javist94/powerhacker/hardware/powerhacker-BOM-costs.xls

ID | Name | Designator | Footprint | Quantity per board | Manufacturer Part | Manufacturer | Supplier | Supplier Part | Part Price | Min. Order | Order qty | Order cost | Manuf. Boards
1 | 220 | R19,R36,R37,R20 | R0805 | 4 | 0805W8F2200T5E | UniOhm | LCSC | C17557 | 0.0017210 € | 100 | 100 | 0.1721 € | 25.0
2 | MICRO5.9MMUSB | USB2 | MICRO-USB-SMD_5P-P0.65-H-F_MICRO5.9MMUSB | 1 | MICRO5.9mmusb | SHOU HAN | LCSC | C393940 | 0.0229090 € | 20 | 20 | 0.4582 € | 20.0 | BOARDS | 2
3 | 10nF | C16,C12,C9,C19 | C0603 | 4 | CGA3E2X7R1H103KT0Y0N | TDK | LCSC | C342901 | 0.0079530 € | 50 | 50 | 0.3977 € | 12.5
4 | 100K | R13 | R0603 | 1 | 0603WAF1003T5E | UniOhm | LCSC | C25803 | 0.0008140 € | 100 | 100 | 0.0814 € | 100.0 | ORDER PRICE | 39.06 €
5 | LTST-C190KGKT | CH2,CH1 | LED0603-RD | 2 | LTST-C190KGKT | LITEON | LCSC | C125094 | 0.0154220 € | 20 | 20 | 0.3084 € | 10.0
6 | 100 | R23 | R0805 | 1 | 0805W8F1000T5E | UniOhm | LCSC | C17408 | 0.0017610 € | 100 | 100 | 0.1761 € | 100.0 | BOARD COST | 19.53 €
7 | 1.62K | R5 | R0603 | 1 | WR06X1621FTL | WTC | LCSC | C170482 | 0.0026650 € | 100 | 100 | 0.2665 € | 100.0
8 | 100nF | C23,C27,C6,C28,C26 | C0603 | 5 | 0603B104K160 | WTC | LCSC | C80516 | 0.0030300 € | 50 | 50 | 0.1515 € | 10.0
9 | 2STBN15D100 | Q4,Q1 | TO-263-2_L10.0-W9.1-P5.08-LS15.2-TL | 2 | 2STBN15D100 | STMicroelectronics | LCSC | C155667 | 0.7183760 € | 2 | 4 | 2.8735 € | 2.0
10 | MAX9934FAUA+ | U4 | MSOP-8_L3.0-W3.0-P0.65-LS5.0-BL | 1 | MAX9934FAUA+ | MAXIM | MOUSER ES | C143634 | 1.9500000 € | 1 | 2 | 3.9000 € | 2.0
11 | AP7381-33Y-13 | U2 | SOT-89-3_L4.5-W2.5-P1.50-LS4.2-BR | 1 | AP7381-33Y-13 | Diodes Incorporated | LCSC | C460411 | 0.1050470 € | 5 | 5 | 0.5252 € | 5.0 | MINIMUM COST | 26.16 €
12 | TPS560430XFDBVR | U9 | SOT-23-6_L2.9-W1.6-P0.95-LS2.8-BR | 1 | TPS560430XFDBVR | Texas Instruments | MOUSER ES | C523980 | 1.0100000 € | 1 | 2 | 2.0200 € | 2.0
13 | 15uH | L1 | IND-SMD_L4.0-W4.0 | 1 | SNR4018K-150M | 3L COILS | LCSC | C326304 | 0.0851220 € | 5 | 5 | 0.4256 € | 5.0
14 | 470 | R3 | R0603 | 1 | WR06X471JTL | WALSIN | LCSC | C163921 | 0.0008170 € | 100 | 100 | 0.0817 € | 100.0
15 | 2.2uF | C32,C25,C38 | C1210 | 3 | C3225X7R2A225KT5L0U | TDK | LCSC | C76686 | 0.2048110 € | 3 | 6 | 1.2289 € | 2.0
16 | 100nF | C39,C40,C34,C5 | C0603 | 4 | CC0603JRX7R9BB104 | YAGEO | LCSC | C91183 | 0.0104070 € | 50 | 50 | 0.5203 € | 12.5
17 | 412K | R31 | R0603 | 1 | ERJ3EKF4123V | PANASONIC | LCSC | C403212 | 0.0066460 € | 50 | 50 | 0.3323 € | 50.0
18 | SS14L | D1 | SMA_L4.4-W2.6-LS5.0-RD | 1 | SS14L | PANJIT | LCSC | C125883 | 0.0392250 € | 10 | 10 | 0.3923 € | 10.0
19 | 32.768KHz | X1 | SMD-3215_2P | 1 | DST310S 32.768KHz | KDS Daishinku | LCSC | C93232 | 0.3423260 € | 1 | 2 | 0.6847 € | 2.0
20 | 10uF | C20 | CAP-SMD_BD4.0-L4.3-W4.3-FD | 1 | EEEFC1C100AR | PANASONIC | LCSC | C401619 | 0.1052510 € | 5 | 5 | 0.5263 € | 5.0
21 | 150nH | L2 | L0603 | 1 | 0603AF-151XJEU | Coilcraft | LCSC | C335693 | 0.3562440 € | 1 | 2 | 0.7125 € | 2.0
22 | STM32F373CCT6 | U5 | LQFP-48_L7.0-W7.0-P0.50-LS9.0-TL | 1 | STM32F373CCT6 | STMicroelectronics | LCSC | C89403 | 2.4642680 € | 1 | 2 | 4.9285 € | 2.0
23 | 19-217/R6C-AL1M2VY/3T | USB,POWER,SD | LED0603-R-RD | 3 | 19-217/R6C-AL1M2VY/3T | EVERLIGHT | LCSC | C72044 | 0.0125040 € | 20 | 20 | 0.2501 € | 6.7
24 | 0.04 | R7 | R0805 | 1 | STE0805MW75R040F | Walter Elec | LCSC | C201265 | 0.0515660 € | 10 | 10 | 0.5157 € | 10.0
25 | 280 | R24,R21 | R0805 | 2 | 0805W8F2800T5E | Uniroyal Elec | LCSC | C247037 | 0.0024400 € | 100 | 100 | 0.2440 € | 50.0
26 | TS-1087S-01626 | SW1,SW2,SW3,SW4 | SW-SMD_L5.2-W5.2-P3.70-LS6.4 | 4 | TS-1087S-01626 | XUNPU | LCSC | C455263 | 0.0294710 € | 20 | 20 | 0.5894 € | 5.0
27 | 1.5K | R14 | R0603 | 1 | TC0325B1501T5E | UNI-ROYAL | LCSC | C39049 | 0.0307830 € | 10 | 10 | 0.3078 € | 10.0
28 | 1M | R11 | R0603 | 1 | 0603WAF1004T5E | UniOhm | LCSC | C22935 | 0.0009860 € | 100 | 100 | 0.0986 € | 100.0
29 | NSI50010YT1G | U12 | SOD-123_L2.8-W1.8-LS3.7-RD | 1 | NSI50010YT1G | ON Semicon | LCSC | C150049 | 0.1020600 € | 5 | 5 | 0.5103 € | 5.0
30 | 100K | R35 | 805 | 1 | 080500F1003T5E | UniOhm | LCSC | C149504 | 0.0021620 € | 100 | 100 | 0.2162 € | 100.0
31 | 470uF | C1 | CAP-SMD_BD10.0-L10.3-W10.3-FD | 1 | RVT1V471M1010 | ROQANG | LCSC | C72519 | 0.0987890 € | 5 | 5 | 0.4939 € | 5.0
32 | 13.7K | R38 | R0603 | 1 | 0603WAD1372T5E | Uniroyal Elec | LCSC | C407628 | 0.0032880 € | 50 | 50 | 0.1644 € | 50.0
33 | 470uF | C3 | CAP-SMD_BD6.3-L6.6-W6.6-FD | 1 | RVT1A471M0607 | ROQANG | LCSC | C335982 | 0.0340650 € | 10 | 10 | 0.3407 € | 10.0
34 | 1uF | C4 | C0603 | 1 | CL10A105KB8NNNC | SAMSUNG | LCSC | C15849 | 0.0075860 € | 50 | 50 | 0.3793 € | 50.0
35 | 10.2K | R2 | R0603 | 1 | 0603WAF1022T5E | UniOhm | LCSC | C22772 | 0.0009050 € | 100 | 100 | 0.0905 € | 100.0
36 | 19-217/BHC-ZL1M2RY/3T | RUN | LED0603-R-RD | 1 | 19-217/BHC-ZL1M2RY/3T | EVERLIGHT | LCSC | C72041 | 0.0137970 € | 20 | 20 | 0.2759 € | 20.0
37 | 100nF | C7 | C1206 | 1 | CGA5L2C0G1H104JT0Y0N | TDK | LCSC | C338082 | 0.4475140 € | 1 | 2 | 0.8950 € | 2.0
38 | 0.1 | R32 | R0603 | 1 | 0603WAJ010KT5E | Uniroyal Elec | LCSC | C247025 | 0.0025000 € | 100 | 100 | 0.2500 € | 100.0
39 | 22 | R34,R33 | R0805 | 2 | 0805W8J0220T5E | UniOhm | LCSC | C25295 | 0.0016810 € | 100 | 100 | 0.1681 € | 50.0
40 | NSR05F20NXT5G | D3 | DSN2_L1.6-W0.8-RD | 1 | NSR05F20NXT5G | ON | LCSC | C94366 | 0.1859560 € | 1 | 2 | 0.3719 € | 2.0
41 | 4.7uF | C35,C36,C2 | CAP-SMD_BD4.0-L4.3-W4.3-FD | 3 | EEEFK1V4R7R | PANASONIC | LCSC | C401730 | 0.1065490 € | 3 | 6 | 0.6393 € | 2.0
42 | 10uF | C37 | C1206 | 1 | CL31B106KBHNNNE | SAMSUNG | LCSC | C89632 | 0.0668770 € | 5 | 5 | 0.3344 € | 5.0
43 | 1N4001W | D7,D4,D5 | SOD-123F_L2.8-W1.8-LS3.7-RD | 3 | 1N4001W | Jingdao | LCSC | C162732 | 0.0054160 € | 50 | 50 | 0.2708 € | 16.7
44 | 100nF | C8,C24 | C0805 | 2 | C2012X7R2A104KT0L0U | TDK | LCSC | C76652 | 0.0215660 € | 20 | 20 | 0.4313 € | 10.0
45 | 5.6pF | C22,C21 | C0603 | 2 | 0603CG5R6C500NT | FH | LCSC | C1674 | 0.0033140 € | 50 | 50 | 0.1657 € | 25.0
46 | 3.3K | R6 | R0805 | 1 | RN732ATTD3301B25 | KOA Speer Elec | LCSC | C186487 | 0.1726020 € | 1 | 2 | 0.3452 € | 2.0
47 | 0.1 | R4 | R0805 | 1 | RTT05R100FTP | RALEC | LCSC | C125639 | 0.0042500 € | 50 | 50 | 0.2125 € | 50.0
48 | 8MHz | X3 | OSC-SMD_4P-L5.0-W3.2-BL | 1 | S5308000201080 | JGHC | LCSC | C390780 | 0.2054440 € | 1 | 2 | 0.4109 € | 2.0
49 | DC-005-5A-2.0 | DC1 | DC-IN-TH_DC-005-5A-2.0 | 1 | DC-005-5A-2.0 | XKB Enterprise | LCSC | C381116 | 0.1618260 € | 1 | 2 | 0.3237 € | 2.0
50 | MAX4172ESA+T | U8 | SOIC-8_L5.0-W4.0-P1.27-LS6.0-BL | 1 | MAX4172ESA+T | Maxim Integrated | MOUSER ES | C113251 | 2.9800000 € | 1 | 2 | 5.9600 € | 2.0
51 | 620 | R22 | R0805 | 1 | RC0805FR-07620RL | YAGEO | LCSC | C137503 | 0.0022600 € | 100 | 100 | 0.2260 € | 100.0
52 | 1uF | C10,C17,C11 | C0603 | 3 | C1608X7R1E105KT000N | TDK | LCSC | C76619 | 0.0185420 € | 20 | 20 | 0.3708 € | 6.7
53 | 220Ω | L3 | L0603 | 1 | BLM18PG221SN1D | MuRata | LCSC | C80165 | 0.0076620 € | 50 | 50 | 0.3831 € | 50.0
54 | 200K | R30 | R0402 | 1 | AECR0402F200KK9 | ResistorToday | LCSC | C328308 | 0.0015310 € | 100 | 100 | 0.1531 € | 100.0
55 | 22uF | C33 | C0805 | 1 | CL21A226MQCLRNC | Samsung Electro-Mechanics | LCSC | C307530 | 0.0286340 € | 10 | 10 | 0.2863 € | 10.0
56 | 100nF | C29,C30,C31 | C0603 | 3 | 0603F104M500NT | FH | LCSC | C42998 | 0.0028960 € | 50 | 50 | 0.1448 € | 16.7
57 | 2K | R39 | R0603 | 1 | WR06X202 JTL | Walsin Tech Corp | LCSC | C384268 | 0.0008000 € | 100 | 100 | 0.0800 € | 100.0
58 | TF-115 | CARD1 | TF-SMD_TF-115 | 1 | TF-115 | XUNPU | LCSC | C266620 | 0.1229630 € | 1 | 2 | 0.2459 € | 2.0
59 | LM358ST | U10 | MSOP-8_L3.0-W3.0-P0.65-LS5.0-BL | 1 | LM358ST | STMicroelectronics | LCSC | C54867 | 0.1293370 € | 1 | 2 | 0.2587 € | 2.0
60 | 4.7uF | C18 | C0805 | 1 | C2012X7R1E475KT000N | TDK | LCSC | C76642 | 0.0819360 € | 5 | 5 | 0.4097 € | 5.0
61 | 10K | R18,R9,R15,R17,R12,R1,R16,R8 | R0603 | 8 | RS-03K1002FT | Guangdong Fenghua Advanced Tech | LCSC | C115324 | 0.0008330 € | 100 | 100 | 0.0833 € | 12.5
