javist94/powerhacker/hardware/schematics/input-stage.pdf

## SMARTBOARD INPUT POWER MANAGEMENT SCHEMATIC

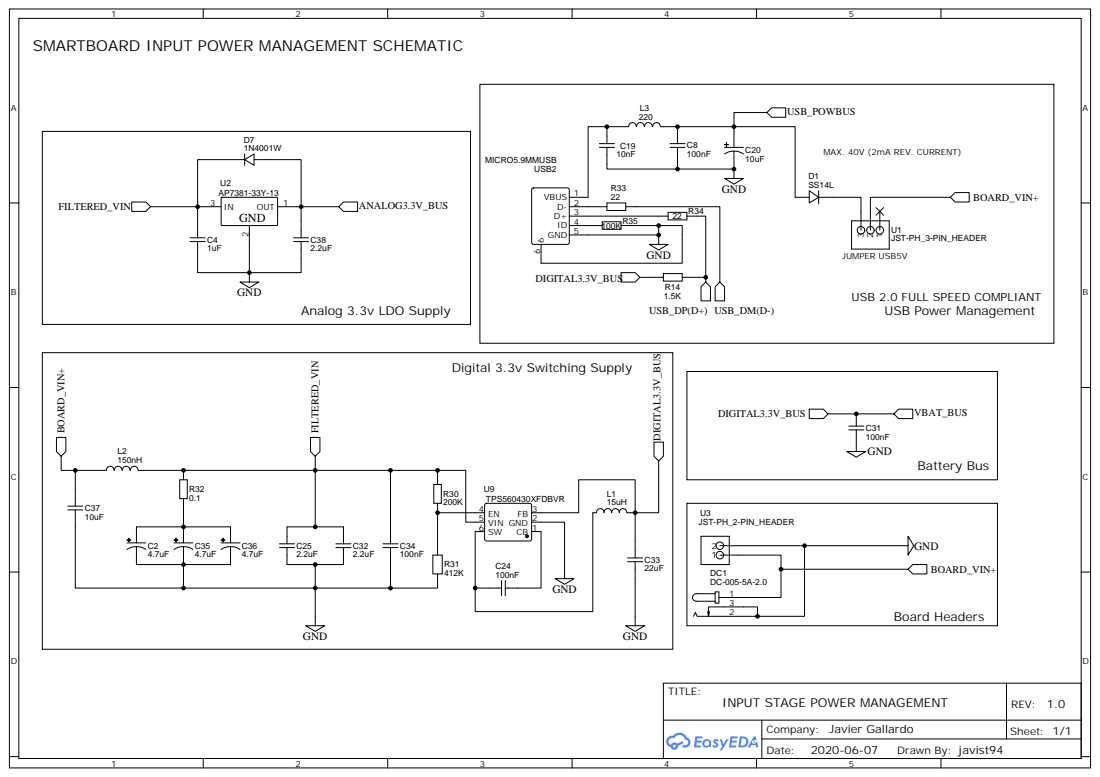
[picture p2: page 1]

USB 2.0 FULL SPEED COMPLIANT
USB Power Management
