javist94/powerhacker/hardware/pcb-routing/pcb-100x60mm-prototype.pdf

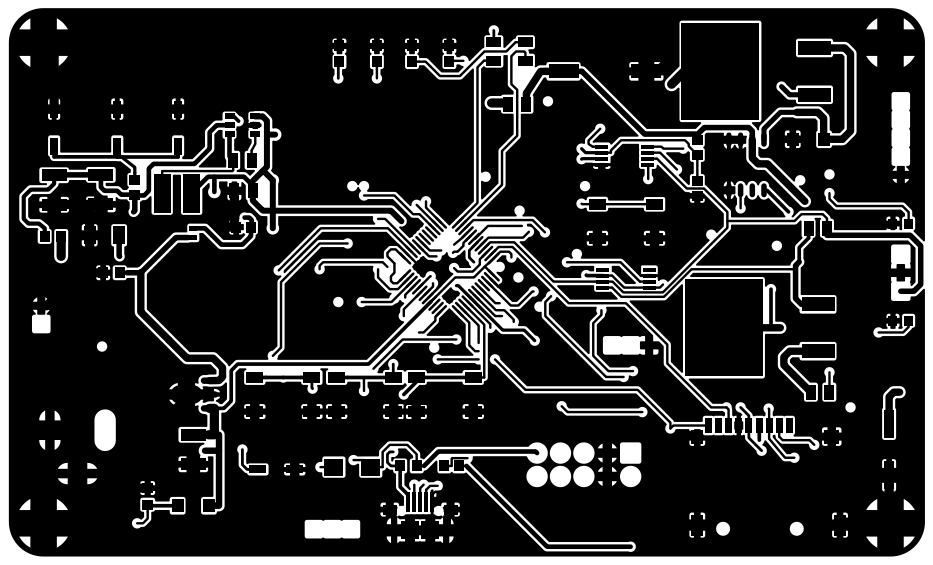
[picture p3: page 1]

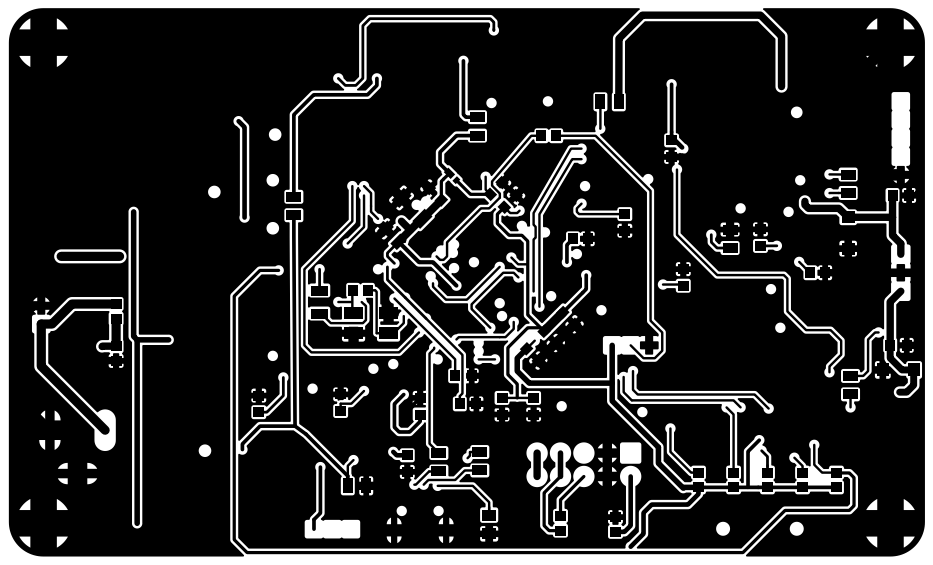
[picture p4: page 2]

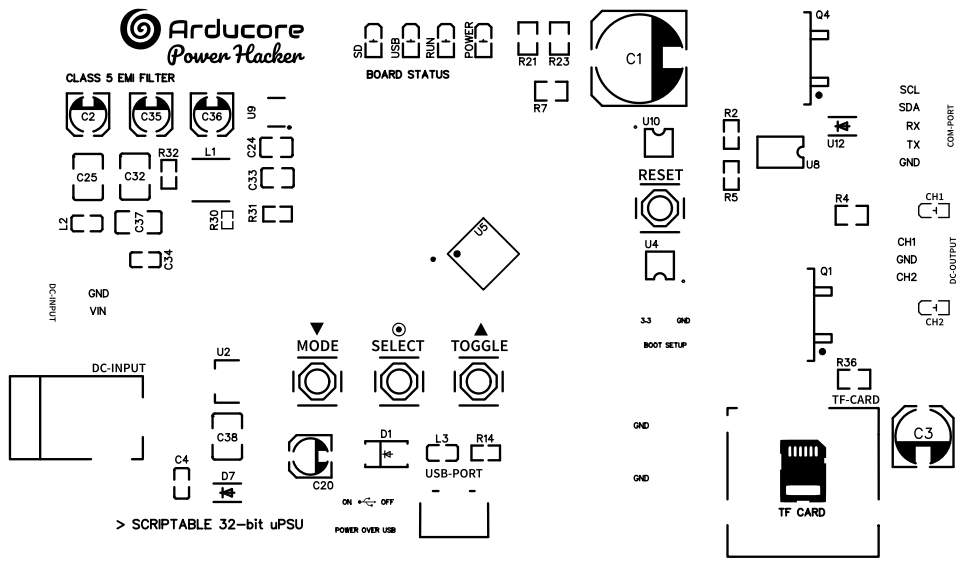
[picture p5: page 3]

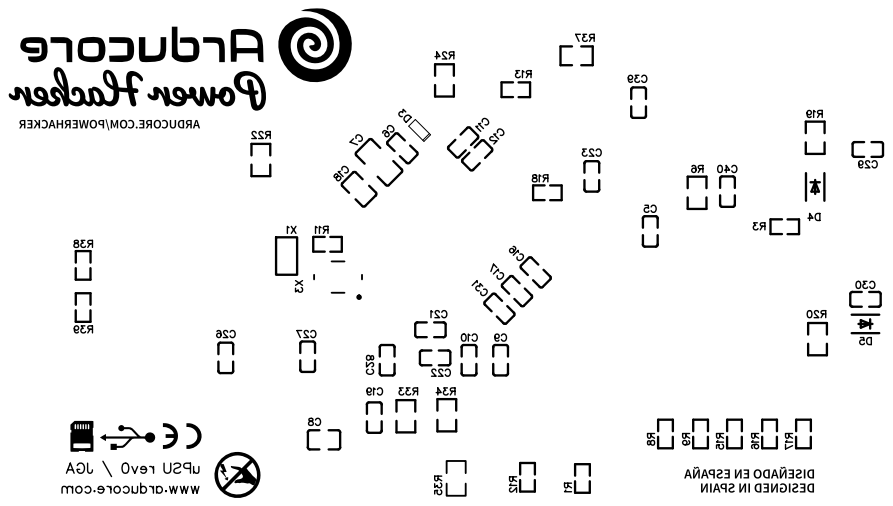
[picture p6: page 4]

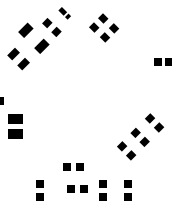
[picture p7: figure]

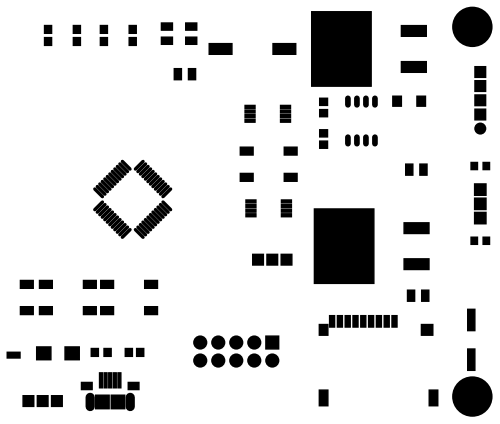
[picture p8: figure]

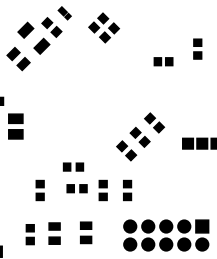
[picture p9: figure]

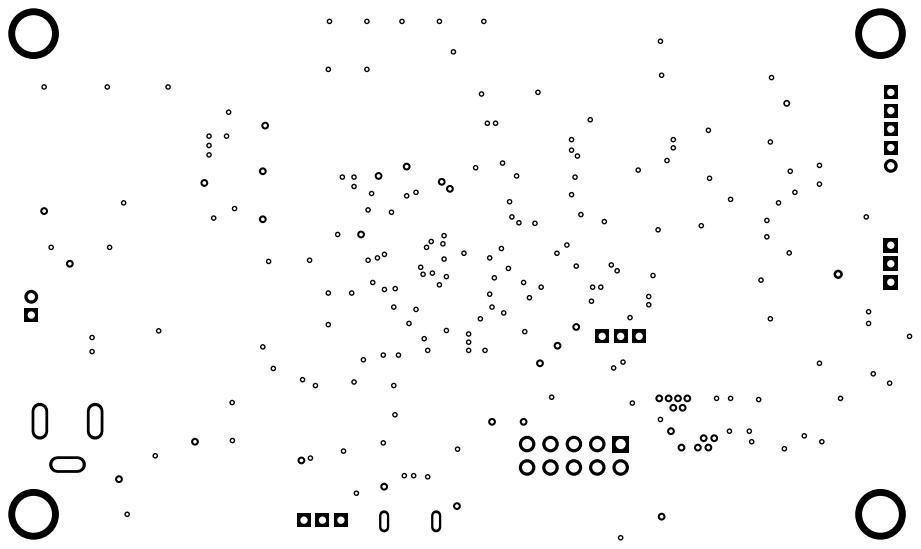
[picture p10: page 10]

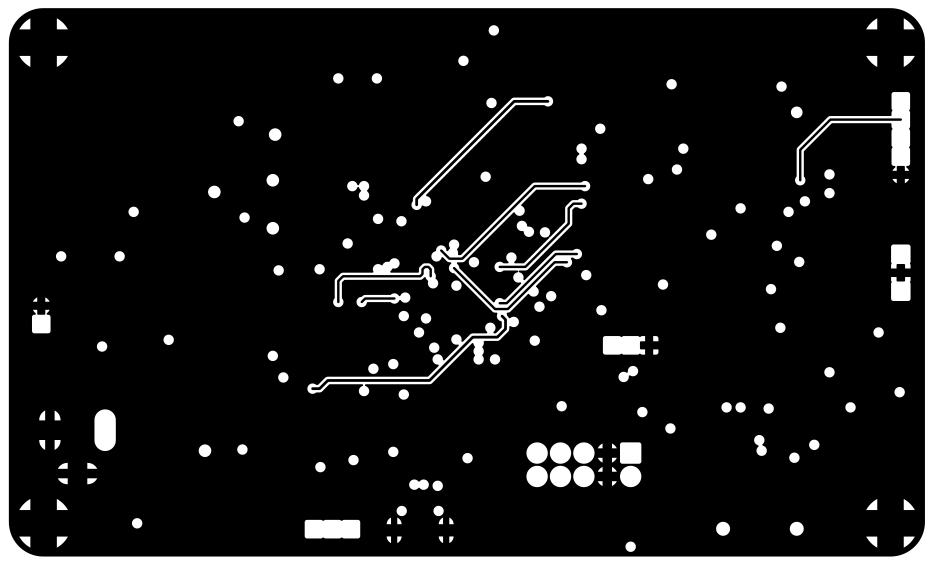
[picture p11: page 12]

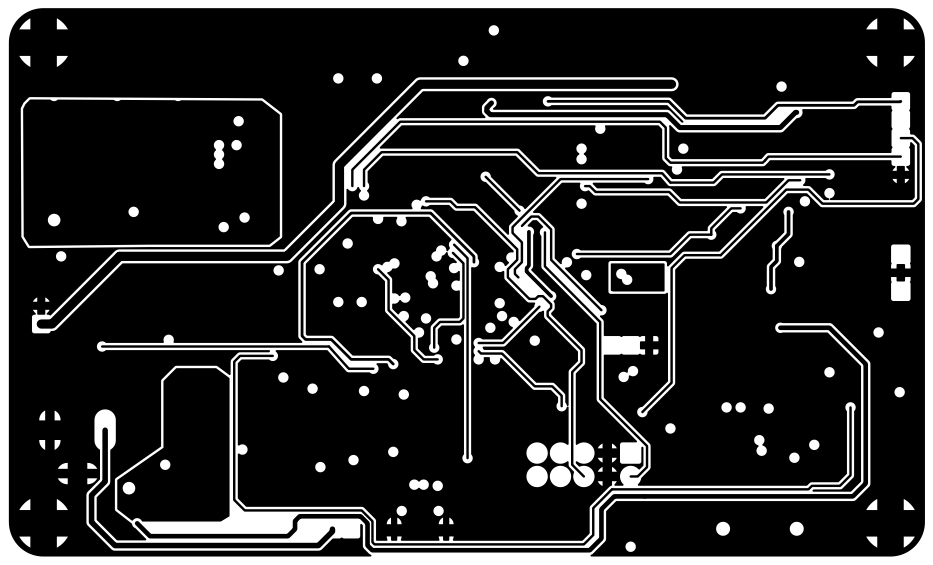
[picture p12: page 13]
