javist94/powerhacker/hardware/schematics/leds-ports-sdcard.pdf

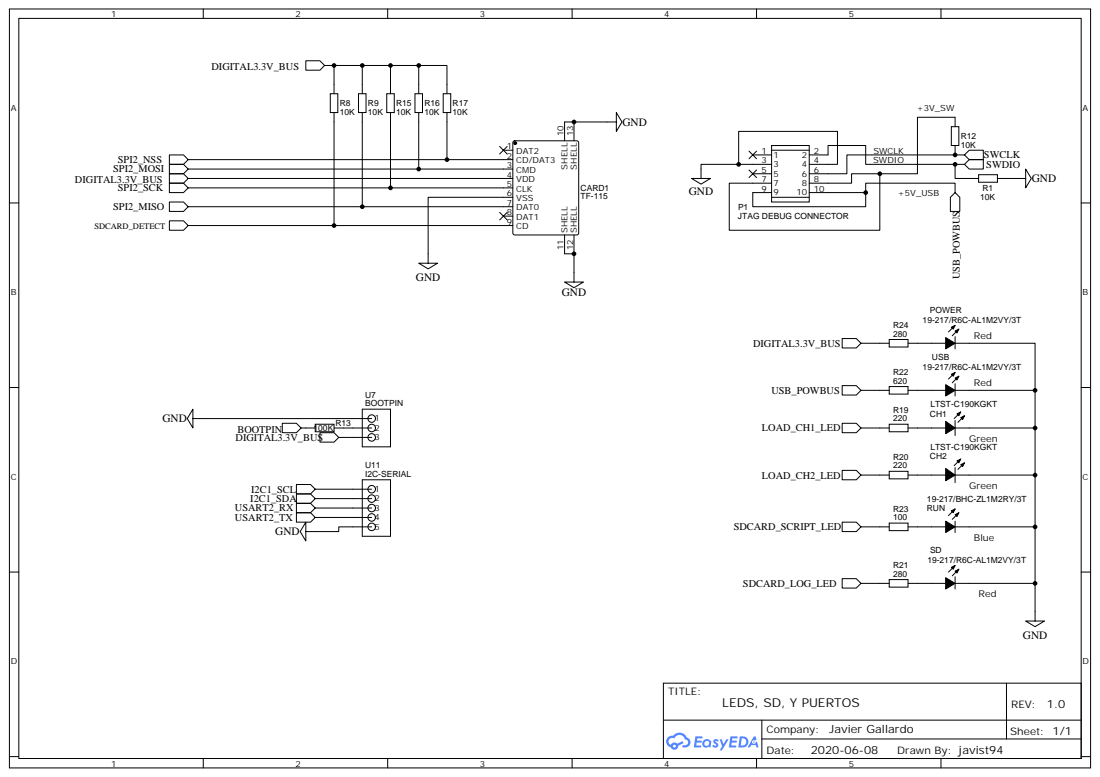
[picture p13: page 1]
