javist94/powerhacker/hardware/schematics/output-stage.pdf

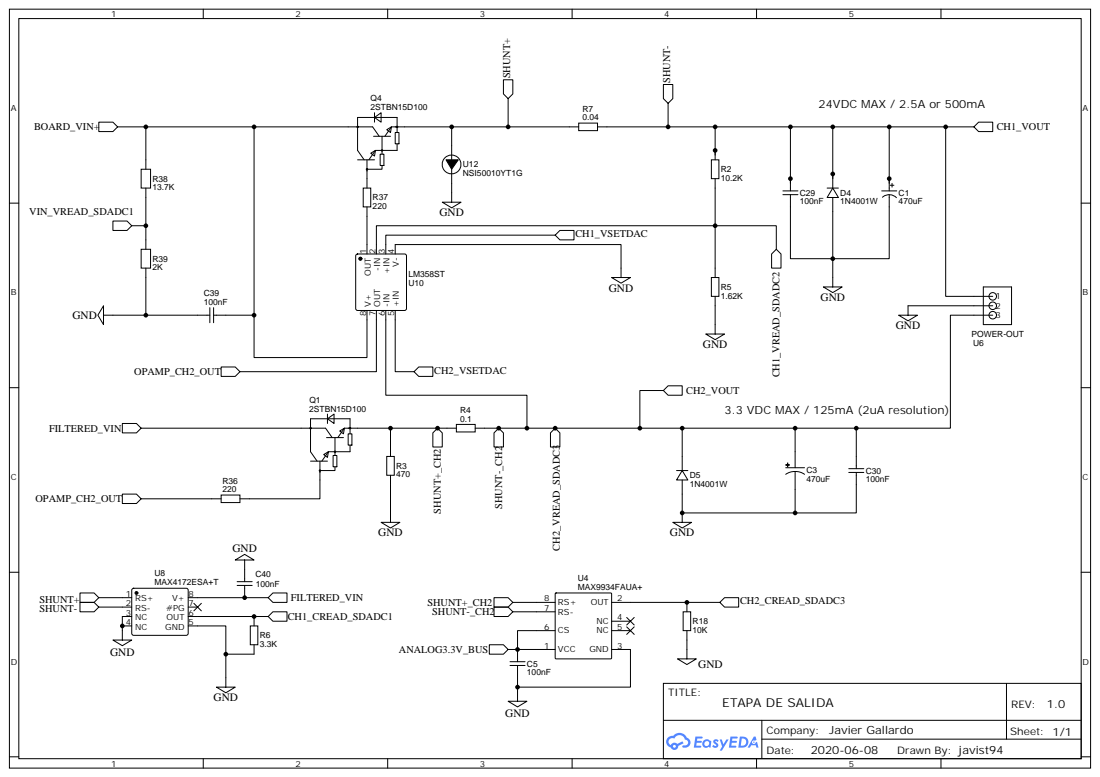
[picture p14: page 1]
