javist94/powerhacker/hardware/schematics/STM32F373.pdf

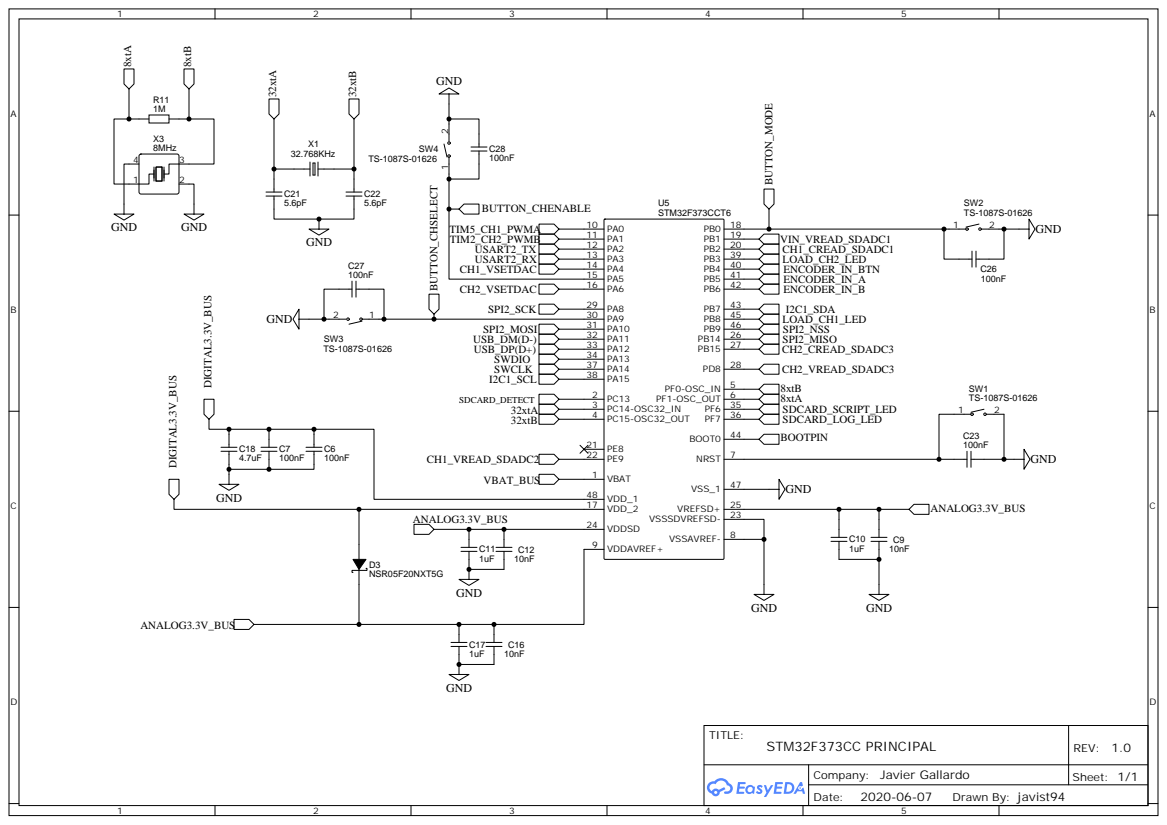
[picture p15: page 1]
