javist94/powerhacker/code/Core/Src/app/main.cpp

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
/* Includes ------------------------------------------------------------------*/
#include "main.h"
#include "usb_device.h"

/* USER CODE BEGIN Includes */
#include <entryPointDefinition.hpp>
/* USER CODE END Includes */

ADC_HandleTypeDef hadc1;

DAC_HandleTypeDef hdac1;
DAC_HandleTypeDef hdac2;

I2C_HandleTypeDef hi2c1;

RTC_HandleTypeDef hrtc;

SDADC_HandleTypeDef hsdadc1;
SDADC_HandleTypeDef hsdadc2;
SDADC_HandleTypeDef hsdadc3;

SPI_HandleTypeDef hspi2;

UART_HandleTypeDef huart2;

void SystemClock_Config(void);
static void MX_GPIO_Init(void);
static void MX_I2C1_Init(void);
static void MX_RTC_Init(void);
static void MX_SDADC1_Init(void);
static void MX_ADC1_Init(void);
static void MX_DAC1_Init(void);
static void MX_DAC2_Init(void);
static void MX_SDADC2_Init(void);
static void MX_SPI2_Init(void);
static void MX_SDADC3_Init(void);
static void MX_USART2_UART_Init(void);
/**
  * @brief  The application entry point.
  * @retval int
  */
int main(void)
{
  /* MCU Configuration--------------------------------------------------------*/

  /* Reset of all peripherals, Initializes the Flash interface and the Systick. */
  HAL_Init();

  /* Configure the system clock */
  SystemClock_Config();

  /* Initialize all configured peripherals */
  MX_GPIO_Init();
  MX_I2C1_Init();
  MX_RTC_Init();
  MX_SDADC1_Init();
  MX_ADC1_Init();
  MX_DAC1_Init();
  MX_DAC2_Init();
  MX_SDADC2_Init();
  MX_SPI2_Init();
  MX_USB_DEVICE_Init();
  MX_SDADC3_Init();
  MX_USART2_UART_Init();
  /* USER CODE BEGIN 2 */
  HAL_DAC_Start(&hdac1, DAC_CHANNEL_1);
  HAL_DAC_SetValue(&hdac1, DAC_CHANNEL_1, DAC_ALIGN_12B_L, 0x100); //TODO: Debug DAC values
  entryPointSetup();
  /* USER CODE END 2 */

  /* Infinite loop */
  /* USER CODE BEGIN WHILE */
  for(;;)
  {
    /* USER CODE END WHILE */

    /* USER CODE BEGIN 3 */
	  entryPointLoop();

  }
  /* USER CODE END 3 */
}

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
 /**
  * @brief  Period elapsed callback in non blocking mode
  * @note   This function is called  when TIM19 interrupt took place, inside
  * HAL_TIM_IRQHandler(). It makes a direct call to HAL_IncTick() to increment
  * a global variable "uwTick" used as application time base.
  * @param  htim : TIM handle
  * @retval None
  */
void HAL_TIM_PeriodElapsedCallback(TIM_HandleTypeDef *htim)
{
  if (htim->Instance == TIM19) {
    HAL_IncTick();
  }
}

/**
  * @brief  This function is executed in case of error occurrence.
  * @retval None
  */
void Error_Handler(void)
{
  /* USER CODE BEGIN Error_Handler_Debug */
  /* User can add his own implementation to report the HAL error return state */

  /* USER CODE END Error_Handler_Debug */
}

#ifdef  USE_FULL_ASSERT
/**
  * @brief  Reports the name of the source file and the source line number
  *         where the assert_param error has occurred.
  * @param  file: pointer to the source file name
  * @param  line: assert_param error line source number
  * @retval None
  */
void assert_failed(uint8_t *file, uint32_t line)
{
  /* USER CODE BEGIN 6 */
  /* User can add his own implementation to report the file name and line number,
     tex: printf("Wrong parameters value: file %s on line %d\r\n", file, line) */
  /* USER CODE END 6 */
}
#endif /* USE_FULL_ASSERT */

/************************ (C) COPYRIGHT STMicroelectronics *****END OF FILE****/
