javist94/powerhacker/code/Core/Inc/main.h

#define CH1_VSETDAC_Pin GPIO_PIN_4
#define CH1_VSETDAC_GPIO_Port GPIOA
#define BUTTON_CHENABLE_Pin GPIO_PIN_5
#define BUTTON_CHENABLE_GPIO_Port GPIOA
#define CH2_VSETDAC_Pin GPIO_PIN_6
#define CH2_VSETDAC_GPIO_Port GPIOA
#define BUTTON_MODE_Pin GPIO_PIN_0
#define BUTTON_MODE_GPIO_Port GPIOB
#define VIN_VREAD_SDADC1_Pin GPIO_PIN_1
#define VIN_VREAD_SDADC1_GPIO_Port GPIOB
#define CH1_CREAD_SDADC1_Pin GPIO_PIN_2
#define CH1_CREAD_SDADC1_GPIO_Port GPIOB
#define CH1_VREAD_SDADC2_Pin GPIO_PIN_9
#define CH1_VREAD_SDADC2_GPIO_Port GPIOE
#define CH2_CREAD_SDADC3_Pin GPIO_PIN_15
#define CH2_CREAD_SDADC3_GPIO_Port GPIOB
#define CH2_VREAD_SDADC3_Pin GPIO_PIN_8
#define CH2_VREAD_SDADC3_GPIO_Port GPIOD
#define BUTTON_CHSELECT_Pin GPIO_PIN_9
#define BUTTON_CHSELECT_GPIO_Port GPIOA
#define SDCARD_SCRIPT_LED_Pin GPIO_PIN_6
#define SDCARD_SCRIPT_LED_GPIO_Port GPIOF
#define SDCARD_LOG_LED_Pin GPIO_PIN_7
#define SDCARD_LOG_LED_GPIO_Port GPIOF
#define LOAD_CH2_LED_Pin GPIO_PIN_3
#define LOAD_CH2_LED_GPIO_Port GPIOB
#define ENCODER_IN_BTN_Pin GPIO_PIN_4
#define ENCODER_IN_BTN_GPIO_Port GPIOB
#define ENCODER_IN_A_Pin GPIO_PIN_5
#define ENCODER_IN_A_GPIO_Port GPIOB
#define ENCODER_IN_B_Pin GPIO_PIN_6
#define ENCODER_IN_B_GPIO_Port GPIOB
#define LOAD_CH1_LED_Pin GPIO_PIN_8
#define LOAD_CH1_LED_GPIO_Port GPIOB
#define PH_DEBUGMODE 1
