javist94/powerhacker/(commit log)

2020-11-11 Added timeout option to the readUntilChar function in USB CDC Class
    With the new timeout option (100 ms by default) we guarantee that the
    last end of line character arrives within the specified time since the
    last character. Else, and error is returned.
    [serialInterfaces.cpp]
2020-12-04 Solved null character printing and hard fault
    [PowerManager.cpp, serialInterfaces.cpp]
2020-12-05 Minor fixes and changes
    [PowerManager.cpp, main.cpp]
2022-05-11 Protocol engine updated to the last specification (#2)
    Squashed commits:
    * JSON Parser engine is functional
    JSON parsing STM32 enabled library installed and ready to be debugged
    * Deserialization routine finished
    * JSON, Serial comms, and basic Vset almost working
    Everything has been implemented. Just a small correction is needed as
    the double value fails to load into the JSON chunk.
    * Protocol engine updated to comply with the latest JSON specification
    * Change of root directory
    [PowerHacker.ioc, PowerManager.cpp, jsonEngine.cpp]
2022-05-11 Hardware schematics, docu and images made public
    [powerhacker-BOM-costs.xls]
2022-05-11 Background removed for board main 3d model
